pacew/eboard/docs/ESP32-PICO-KIT_V4.1_20180314_EN/04_BOM List/BOM_List.xls

ESP32-PICO-KIT_V4.1 BOM_List(V0.9)
ID | Qty | Ref Des | Value | Package | ICs | Description
1 | 1 | ANT1 | Proant440 | PROANTONBOARD440 | Antenna | 3D Antenna
2 | 2 | C2,C4 | 10uF/25V(10%) | 0603C | Capacitance | Ceramic Capacitor
3 | 5 | C6,C7,C12,C16,C19 | 0.1uF/25V(10%) | 0402C | Capacitance | Ceramic Capacitor
4 | 1 | C15 | 10uF/6.3V(10%) | 0402C | Capacitance | Ceramic Capacitor
5 | 1 | C17 | 2.7pF±0.5pF/25V | 0402C | Capacitor | Ceramic Capacitor
6 | 1 | C18 | 1.6nH±0.3nH | 0402C | Inductor | Inductor
7 | 1 | D1 | RED LED | 0603D/A | LED | Red LED
8 | 1 | D2 | BAT760-7 | SOD-323 | Diode | Diode
9 | 3 | D3,D4,D5 | LESD5D5.0CT1G | SOD-523 | ESD | ESD 5V
10 | 1 | J1 | USB_CON8 | USB_5P | Connector | USB Connector
11 | 2 | J2,J3 | 2.54mm single-row pin headers 17P | CON20_2P54 | Connector | Male Header
12 | 1 | L1 | 4.7pF±0.5pF/25V | 0402C | Capacitor | Ceramic Capacitor
13 | 2 | Q1,Q2 | S8050(NPN) | SOT-23-3 | Transistor | Transistor(NPN)
14 | 2 | R1,R27 | 2K(1%) | 0402R | Resistor | Resistor
15 | 5 | R3,R4,R6,R7,R21 | 0R(1%) | 0402R | Resistor | Resistor
16 | 2 | R15,R16 | 1K(1%) | 0402R | Resistor | Resistor
17 | 3 | R19,R20,R22 | 10K(1%) | 0402R | Resistor | Resistor
18 | 1 | R24 | 22.1K(1%) | 0402R | Resistor | Resistor
19 | 1 | R26 | 47.5K(1%) | 0402R | Resistor | Resistor
20 | 2 | SW1,SW2 | SW PUSHBUTTON | SW_3X4X2MM | Push Button | Push Button
21 | 1 | U1 | AMS1117-3.3 | SOT-223 | Power IC | Power IC
22 | 1 | U4 | CP2102N | QFN28-5X5-0P5 | IC Chip | USB2UART Bridge
23 | 1 | U5 | ESP32-PICO-D4 | QFN48_7X7 | IC Chip | ESP32-SIP
