pacew/eboard/docs/old.pdf

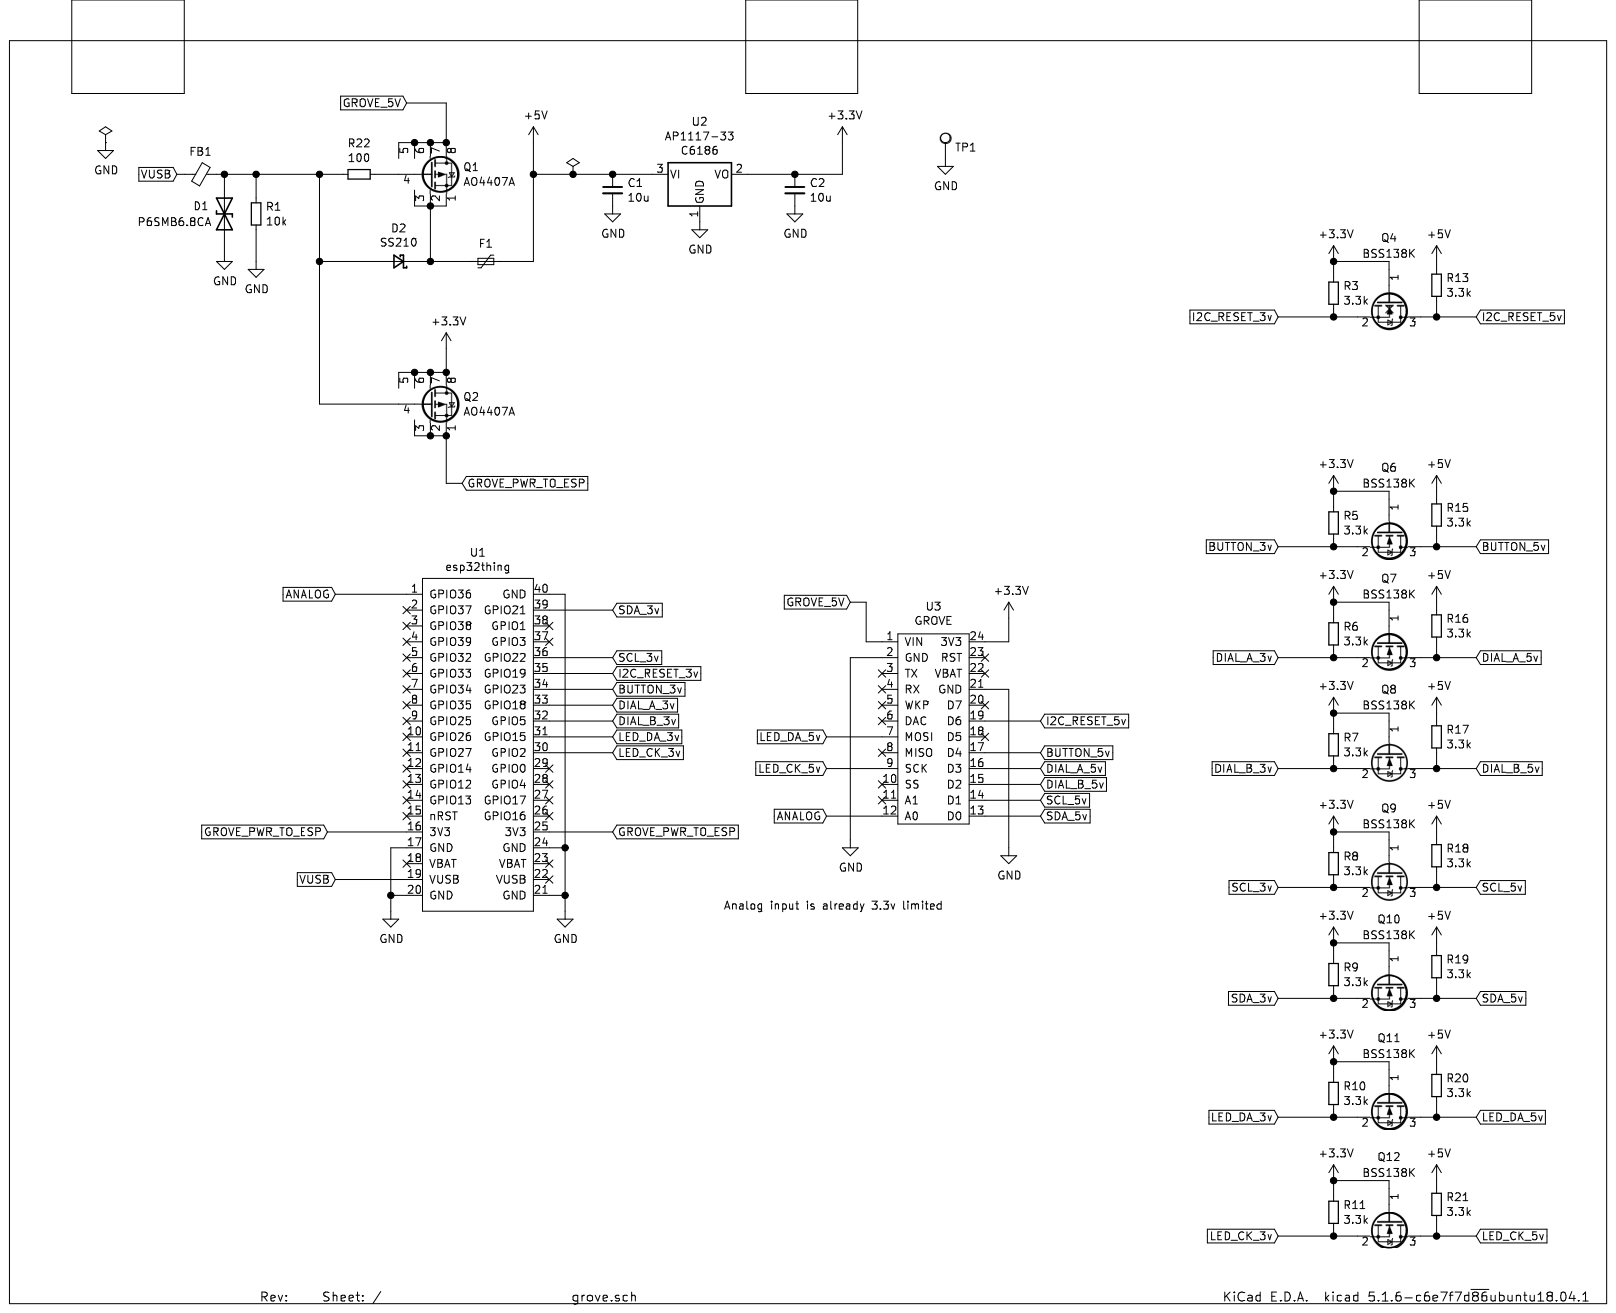
[picture p1: page 1]
