pacew/eboard/(list of files, drawings)

Other design files:
docs/ESP32-PICO-KIT_V4.1_20180314_EN/01_Schematic/ESP32-PICO-KIT-V4.1_0314.DSN
docs/ESP32-PICO-KIT_V4.1_20180314_EN/01_Schematic/esp32-pico-kit-v4.1_0314.opj
docs/ESP32-PICO-KIT_V4.1_20180314_EN/02_PCB Layout/ESP32-PICO-KIT_V4.1_20180314.pcb
