pacew/eboard/eboard/eboard.kicad_pcb

## KiCad design eboard/eboard.kicad_pcb (2021-02-27)

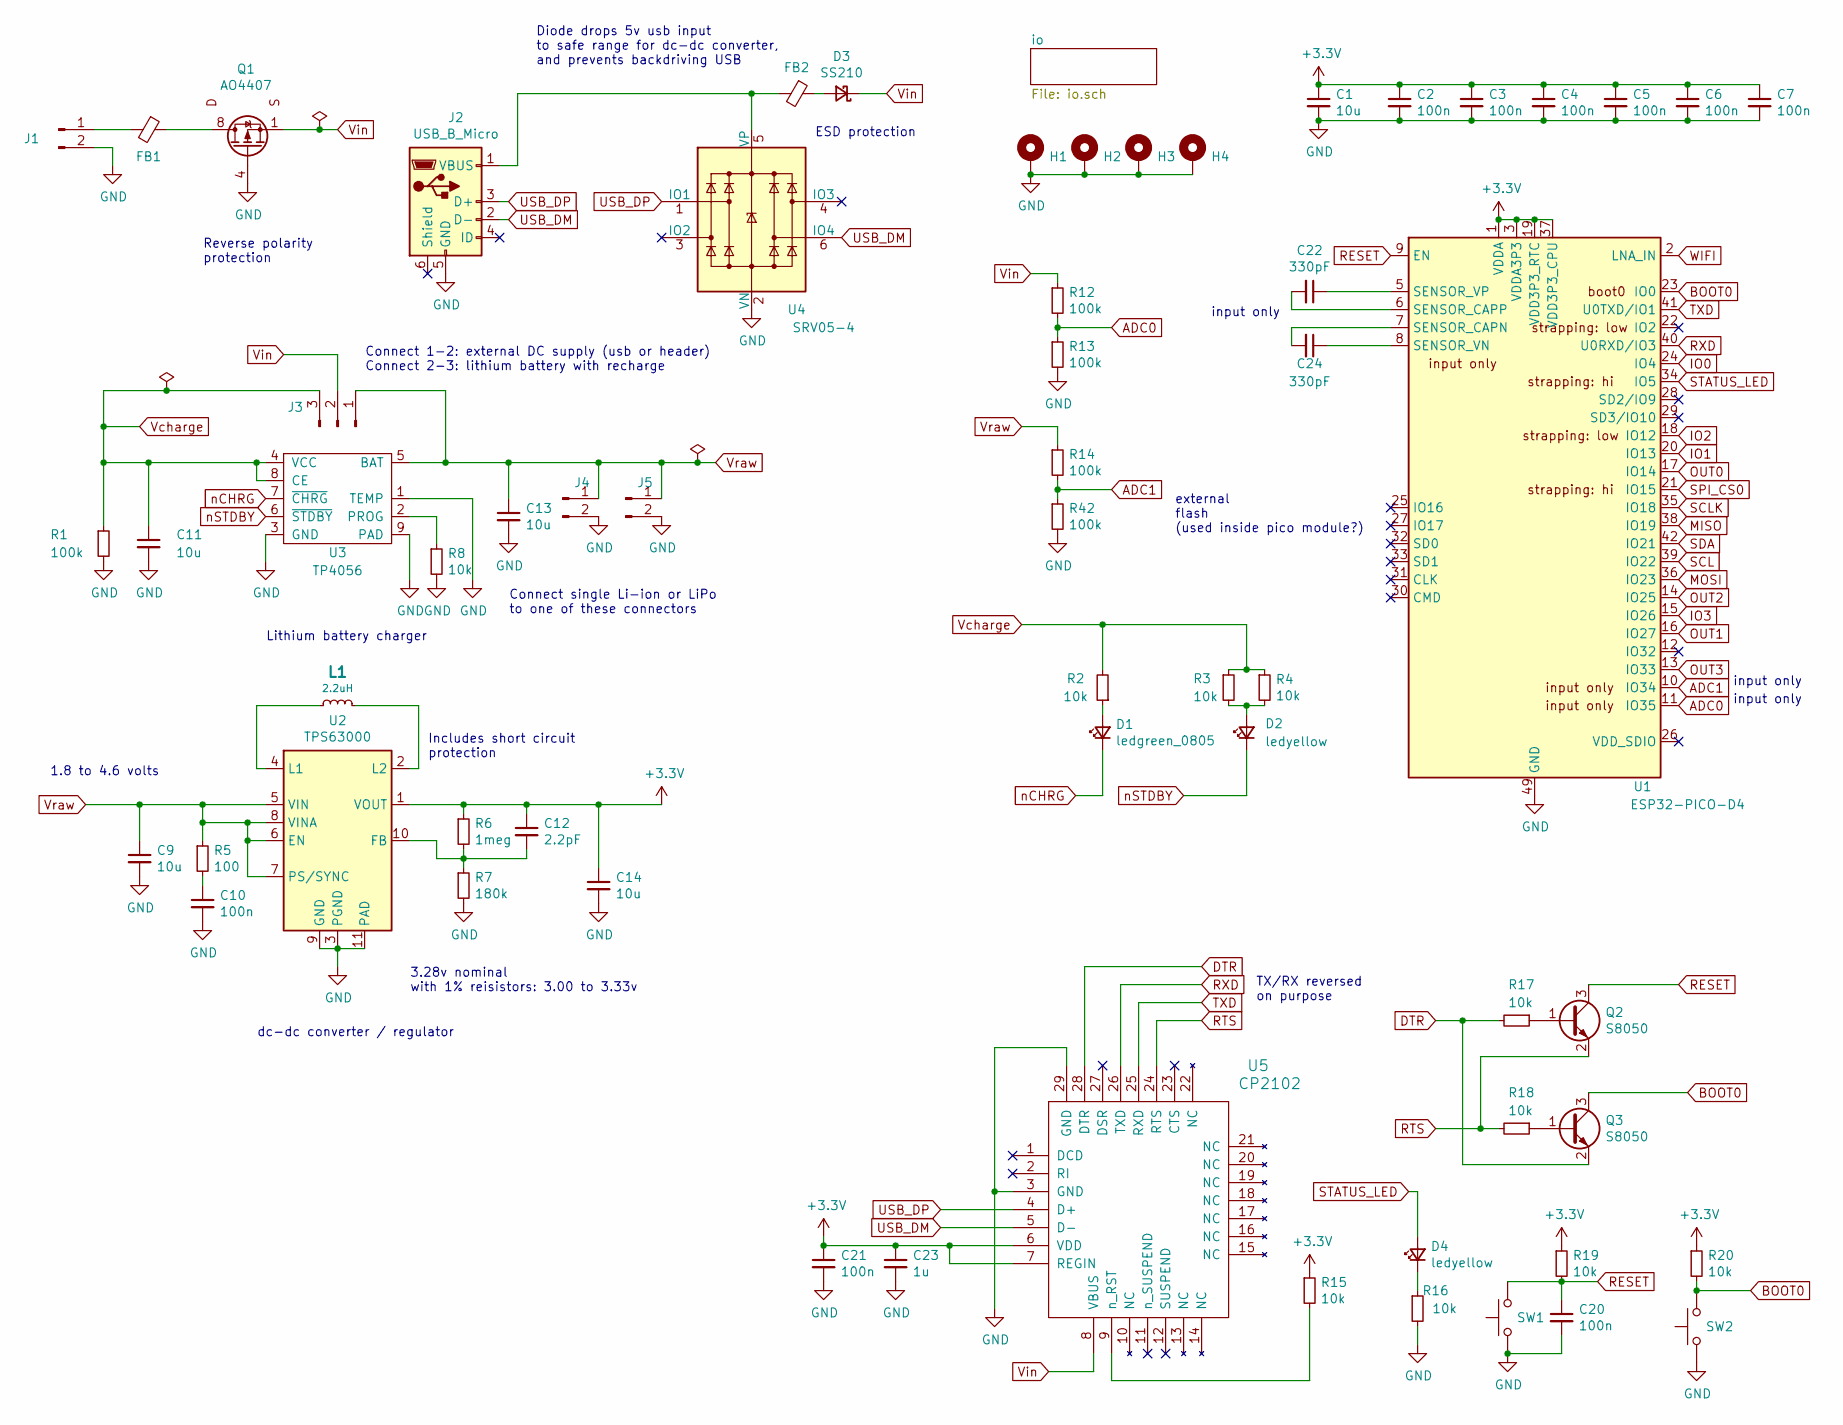
[picture p2: schematic eboard.sch]

Parts:
C1, C9, C11, C13, C14: 10u; C_0402_1005Metric; LCSC C15525
C2, C3, C4, C5, C6, C7, C10, C20, C21: 100n; C_0402_1005Metric; LCSC C1525
C12: 2.2pF; C_0402_1005Metric; LCSC C1559
C22, C24: 330pF; C_0402_1005Metric; LCSC C13533
C23: 1u; C_0402_1005Metric; LCSC C52923
D1: ledgreen_0805; LED_0805_2012Metric; LCSC C2297
D2, D4: ledyellow; LED_0603_1608Metric; LCSC C72038
D3: SS210; D_SMA; LCSC C14996
FB1, FB2: bead; L_0805_2012Metric; LCSC C1015
H1, H2, H3, H4: MountingHole_Pad; MountingHole_3.2mm_M3_Pad
J1, J5: Conn_01x02_Male; PinHeader_1x02_P2.54mm_Vertical
J2: USB_B_Micro; USB_Micro-B_Molex-105017-0001
J3: Conn_01x03_Male; PinHeader_1x03_P2.54mm_Vertical
J4: jst_battery; JST_PH_B2B-PH-K_1x02_P2.00mm_Vertical
L1: 2.2uH; L_Coilcraft_XxL4020; LCSC C167747
Q1: AO4407; SOIC-8_3.9x4.9mm_P1.27mm; LCSC C469397
Q2, Q3: S8050; SOT-23; LCSC C2146
R1, R12, R13, R14, R42: 100k; R_0402_1005Metric; LCSC C25741
R2, R3, R4, R8, R15, R16, R17, R18, R19, R20: 10k; R_0402_1005Metric; LCSC C25744
R5: 100; R_0402_1005Metric; LCSC C25076
R6: 1meg; R_0603_1608Metric; LCSC C22935
R7: 180k; R_0603_1608Metric; LCSC C22827
SW1, SW2: pushbutton_switch; SW_PUSH_6mm
U1: ESP32-PICO-D4; QFN-48-1EP_7x7mm_P0.5mm_EP5.3x5.3mm; LCSC C193707
U2: TPS63000; Texas_DRC0010J_ThermalVias; LCSC C24966
U3: TP4056; SOIC-8-1EP_3.9x4.9mm_P1.27mm_EP2.29x3mm_ThermalVias; LCSC C16581
U4: SRV05-4; SOT-23-6; LCSC C85364
U5: CP2102; QFN-28-1EP_5x5mm_P0.5mm_EP3.35x3.35mm_ThermalVias; LCSC C6568

Connections:
+3V3: C1.1, C2.1, C3.1, C4.1, C5.1, C6.1, C7.1, C12.1, C14.1, C21.1, C23.1, R6.1, R15.1, R19.1, R20.1, U1.1 (VDDA), U1.3 (VDDA3P3), U1.4 (VDDA3P3), U1.19 (VDD3P3_RTC), U1.37 (VDD3P3_CPU), U1.43 (VDDA), U1.46 (VDDA), U2.1 (VOUT), U5.6 (VDD), U5.7 (REGIN); also elsewhere on the board
ADC0: R12.2, R13.1, U1.11 (IO35)
ADC1: R14.2, R42.1, U1.10 (IO34)
BOOT0: Q3.3 (C), R20.2, SW2.2, U1.23 (IO0)
DTR: Q3.2 (E), R17.2, U5.28 (DTR)
GND: C1.2, C2.2, C3.2, C4.2, C5.2, C6.2, C7.2, C9.2, C10.2, C11.2, C13.2, C14.2, C20.2, C21.2, C23.2, H1.1, H2.1, H3.1, H4.1, J1.2, J2.5 (GND), J4.2, J5.2, Q1.4 (G), R1.2, R7.2, R8.2, R13.2, R16.2, R42.2, SW1.1, SW2.1, U1.49 (GND), U2.3 (PGND), U2.9 (GND), U2.11 (PAD), U3.1 (TEMP), U3.3 (GND), U3.9 (PAD), U4.2 (VN), U5.3 (GND), U5.29 (GND); also elsewhere on the board
IO0: U1.24 (IO4); also elsewhere on the board
IO1: U1.20 (IO13); also elsewhere on the board
IO2: U1.18 (IO12); also elsewhere on the board
IO3: U1.15 (IO26); also elsewhere on the board
MISO: U1.38 (IO19); also elsewhere on the board
MOSI: U1.36 (IO23); also elsewhere on the board
unnamed: C10.1, R5.2
unnamed: C12.2, R6.2, R7.1, U2.10 (FB)
unnamed: C22.1, U1.5 (SENSOR_VP)
unnamed: C22.2, U1.6 (SENSOR_CAPP)
unnamed: C24.1, U1.8 (SENSOR_VN)
unnamed: C24.2, U1.7 (SENSOR_CAPN)
unnamed: D1.2 (A), R2.1
unnamed: D2.2 (A), R3.2, R4.2
unnamed: D3.2 (A), FB2.1
unnamed: D4.1 (K), R16.1
unnamed: FB1.1, Q1.5 (Dd), Q1.6 (Dc), Q1.7 (Db), Q1.8 (D)
unnamed: FB1.2, J1.1
unnamed: FB2.2, J2.1 (VBUS), U4.5 (VP)
unnamed: L1.1, U2.4 (L1)
unnamed: L1.2, U2.2 (L2)
unnamed: Q2.1 (B), R17.1
unnamed: Q3.1 (B), R18.1
unnamed: R8.1, U3.2 (PROG)
unnamed: R15.2, U5.9 (n_RST)
OUT0: U1.17 (IO14); also elsewhere on the board
OUT1: U1.16 (IO27); also elsewhere on the board
OUT2: U1.14 (IO25); also elsewhere on the board
OUT3: U1.13 (IO33); also elsewhere on the board
RESET: C20.1, Q2.3 (C), R19.2, SW1.2, U1.9 (EN)
RTS: Q2.2 (E), R18.2, U5.24 (RTS)
RXD: U1.40 (U0RXD/IO3), U5.26 (TXD)
SCL: U1.39 (IO22); also elsewhere on the board
SCLK: U1.35 (IO18); also elsewhere on the board
SDA: U1.42 (IO21); also elsewhere on the board
SPI_CS0: U1.21 (IO15); also elsewhere on the board
STATUS_LED: D4.2 (A), U1.34 (IO5)
TXD: U1.41 (U0TXD/IO1), U5.25 (RXD)
USB_DM: J2.2 (D-), U4.6 (IO4), U5.5 (D-)
USB_DP: J2.3 (D+), U4.1 (IO1), U5.4 (D+)
Vcharge: C11.1, J3.3, R1.1, R2.2, R3.1, R4.1, U3.4 (VCC), U3.8 (CE)
Vin: D3.1 (K), J3.2, Q1.1 (S), Q1.2 (Sb), Q1.3 (Sc), R12.1, U5.8 (VBUS)
Vraw: C9.1, C13.1, J3.1, J4.1, J5.1, R5.1, R14.1, U2.5 (VIN), U2.6 (EN), U2.7 (PS/SYNC), U2.8 (VINA), U3.5 (BAT)
WIFI: U1.2 (LNA_IN); also elsewhere on the board
nCHRG: D1.1 (K), U3.7 (~CHRG)
nSTDBY: D2.1 (K), U3.6 (~STDBY)

Notes on the sheet:
3.28v nominal with 1% reisistors: 3.00 to 3.33v
Includes short circuit protection
1.8 to 4.6 volts
Reverse polarity protection
ESD protection
Lithium battery charger
dc-dc converter / regulator
Connect 1-2: external DC supply (usb or header) Connect 2-3: lithium battery with recharge
Connect single Li-ion or LiPo to one of these connectors
external flash (used inside pico module?)
input only
Diode drops 5v usb input to safe range for dc-dc converter, and prevents backdriving USB
TX/RX reversed on purpose

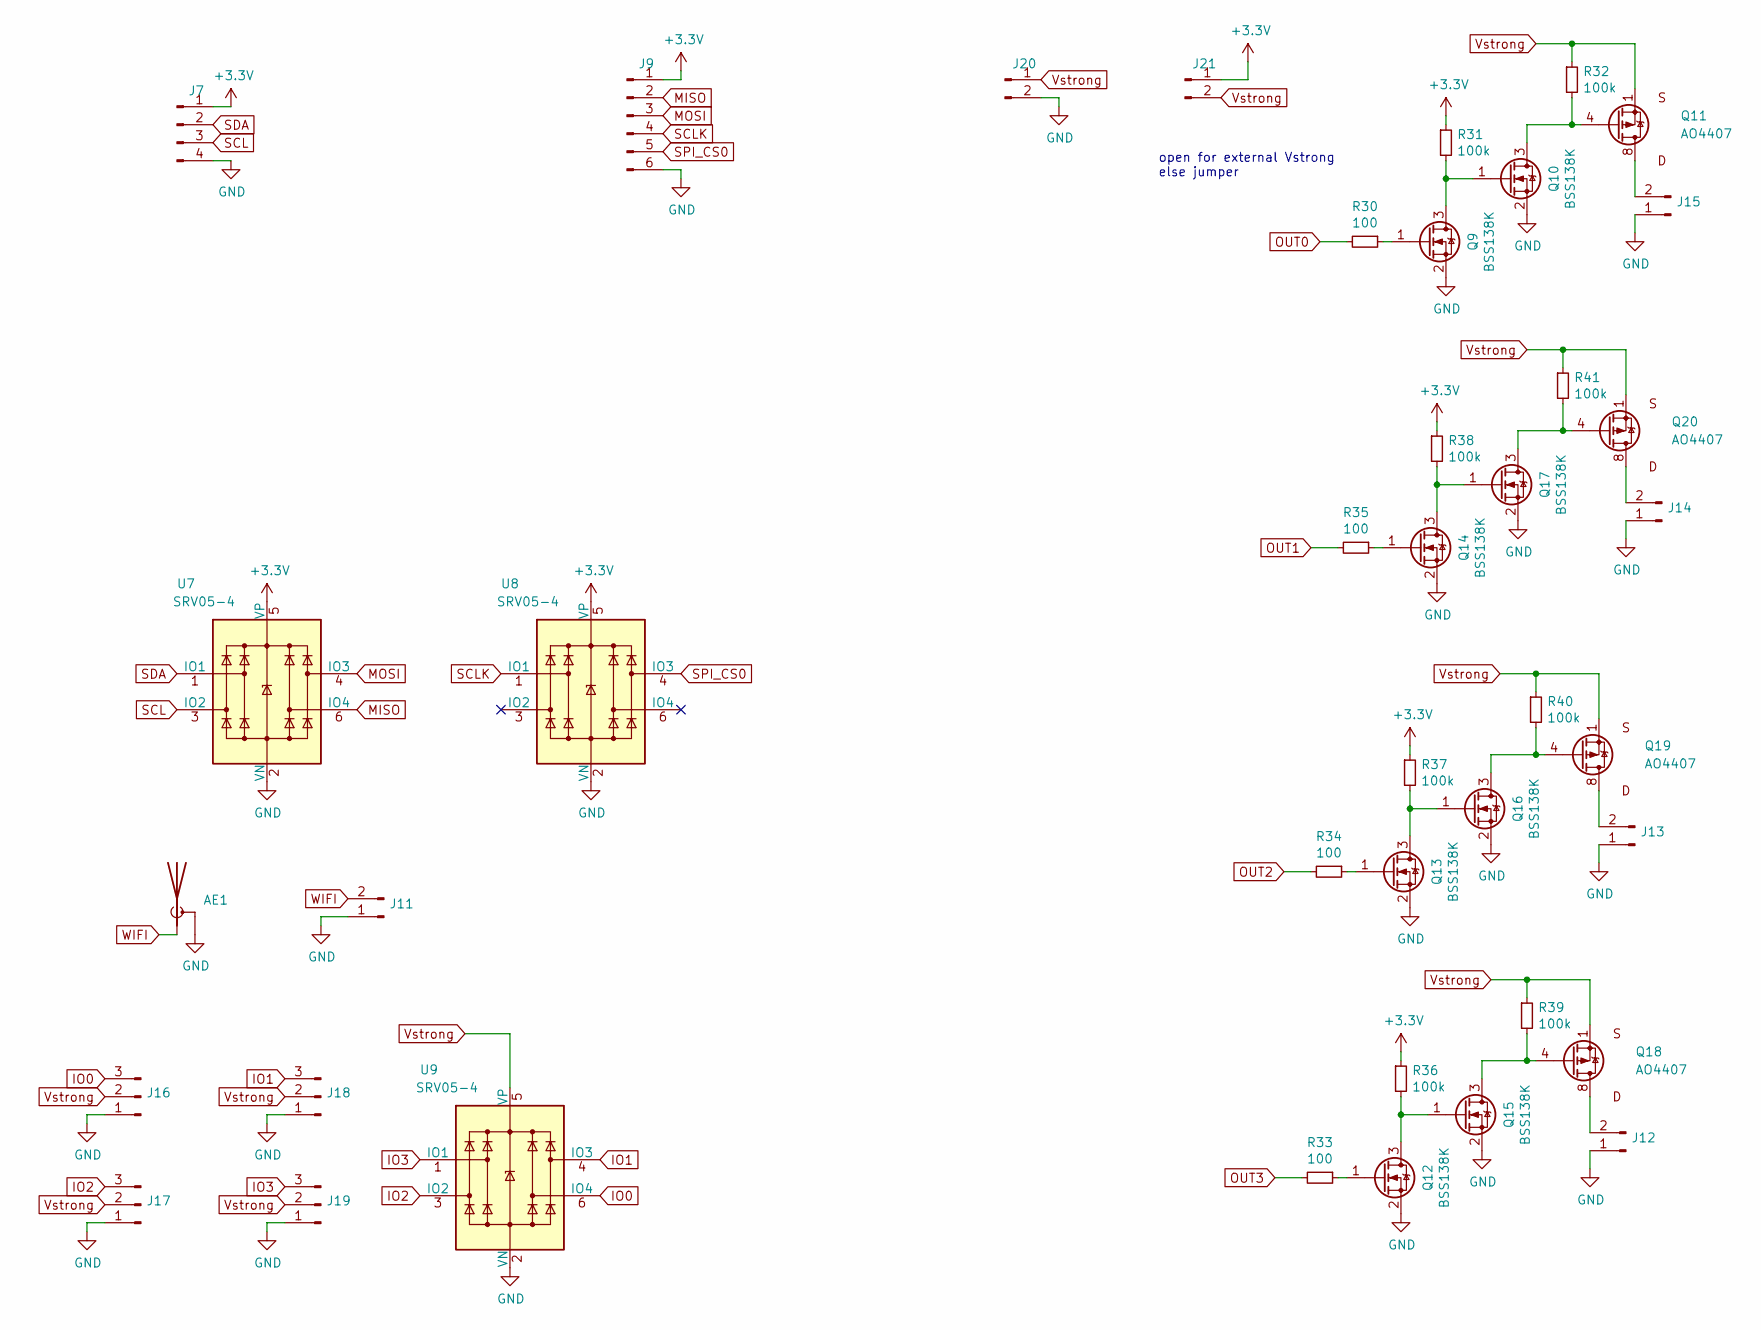
[picture p3: schematic io.sch]

Parts:
AE1: Antenna_Shield; SMA_Samtec_SMA-J-P-X-ST-EM1_EdgeMount
J7: Conn_01x04_Male; PinHeader_1x04_P2.54mm_Vertical
J9: Conn_01x06_Male; PinHeader_1x06_P2.54mm_Vertical
J11, J12, J13, J14, J15, J20, J21: Conn_01x02_Male; PinHeader_1x02_P2.54mm_Vertical
J16, J17, J18, J19: Conn_01x03_Male; PinHeader_1x03_P2.54mm_Vertical
Q9, Q10, Q12, Q13, Q14, Q15, Q16, Q17: BSS138K; SOT-23; LCSC C255592
Q11, Q18, Q19, Q20: AO4407; SOIC-8_3.9x4.9mm_P1.27mm; LCSC C469397
R30, R33, R34, R35: 100; R_0402_1005Metric; LCSC C25076
R31, R32, R36, R37, R38, R39, R40, R41: 100k; R_0402_1005Metric; LCSC C25741
U7, U8, U9: SRV05-4; SOT-23-6; LCSC C85364

Connections:
+3V3: J7.1, J9.1, J21.1, R31.1, R36.1, R37.1, R38.1, U7.5 (VP), U8.5 (VP); also elsewhere on the board
GND: AE1.2 (Shield), J7.4, J9.6, J11.1, J12.1, J13.1, J14.1, J15.1, J16.1, J17.1, J18.1, J19.1, J20.2, Q9.2 (S), Q10.2 (S), Q12.2 (S), Q13.2 (S), Q14.2 (S), Q15.2 (S), Q16.2 (S), Q17.2 (S), U7.2 (VN), U8.2 (VN), U9.2 (VN); also elsewhere on the board
IO0: J16.3, U9.6 (IO4); also elsewhere on the board
IO1: J18.3, U9.4 (IO3); also elsewhere on the board
IO2: J17.3, U9.3 (IO2); also elsewhere on the board
IO3: J19.3, U9.1 (IO1); also elsewhere on the board
MISO: J9.2, U7.6 (IO4); also elsewhere on the board
MOSI: J9.3, U7.4 (IO3); also elsewhere on the board
unnamed: J12.2, Q18.5 (Dd), Q18.6 (Dc), Q18.7 (Db), Q18.8 (D)
unnamed: J13.2, Q19.5 (Dd), Q19.6 (Dc), Q19.7 (Db), Q19.8 (D)
unnamed: J14.2, Q20.5 (Dd), Q20.6 (Dc), Q20.7 (Db), Q20.8 (D)
unnamed: J15.2, Q11.5 (Dd), Q11.6 (Dc), Q11.7 (Db), Q11.8 (D)
unnamed: Q9.1 (G), R30.1
unnamed: Q9.3 (D), Q10.1 (G), R31.2
unnamed: Q10.3 (D), Q11.4 (G), R32.2
unnamed: Q12.1 (G), R33.1
unnamed: Q12.3 (D), Q15.1 (G), R36.2
unnamed: Q13.1 (G), R34.1
unnamed: Q13.3 (D), Q16.1 (G), R37.2
unnamed: Q14.1 (G), R35.1
unnamed: Q14.3 (D), Q17.1 (G), R38.2
unnamed: Q15.3 (D), Q18.4 (G), R39.2
unnamed: Q16.3 (D), Q19.4 (G), R40.2
unnamed: Q17.3 (D), Q20.4 (G), R41.2
OUT0: R30.2; also elsewhere on the board
OUT1: R35.2; also elsewhere on the board
OUT2: R34.2; also elsewhere on the board
OUT3: R33.2; also elsewhere on the board
SCL: J7.3, U7.3 (IO2); also elsewhere on the board
SCLK: J9.4, U8.1 (IO1); also elsewhere on the board
SDA: J7.2, U7.1 (IO1); also elsewhere on the board
SPI_CS0: J9.5, U8.4 (IO3); also elsewhere on the board
Vstrong: J16.2, J17.2, J18.2, J19.2, J20.1, J21.2, Q11.1 (S), Q11.2 (Sb), Q11.3 (Sc), Q18.1 (S), Q18.2 (Sb), Q18.3 (Sc), Q19.1 (S), Q19.2 (Sb), Q19.3 (Sc), Q20.1 (S), Q20.2 (Sb), Q20.3 (Sc), R32.1, R39.1, R40.1, R41.1, U9.5 (VP)
WIFI: AE1.1 (A), J11.2; also elsewhere on the board

Notes on the sheet:
open for external Vstrong else jumper

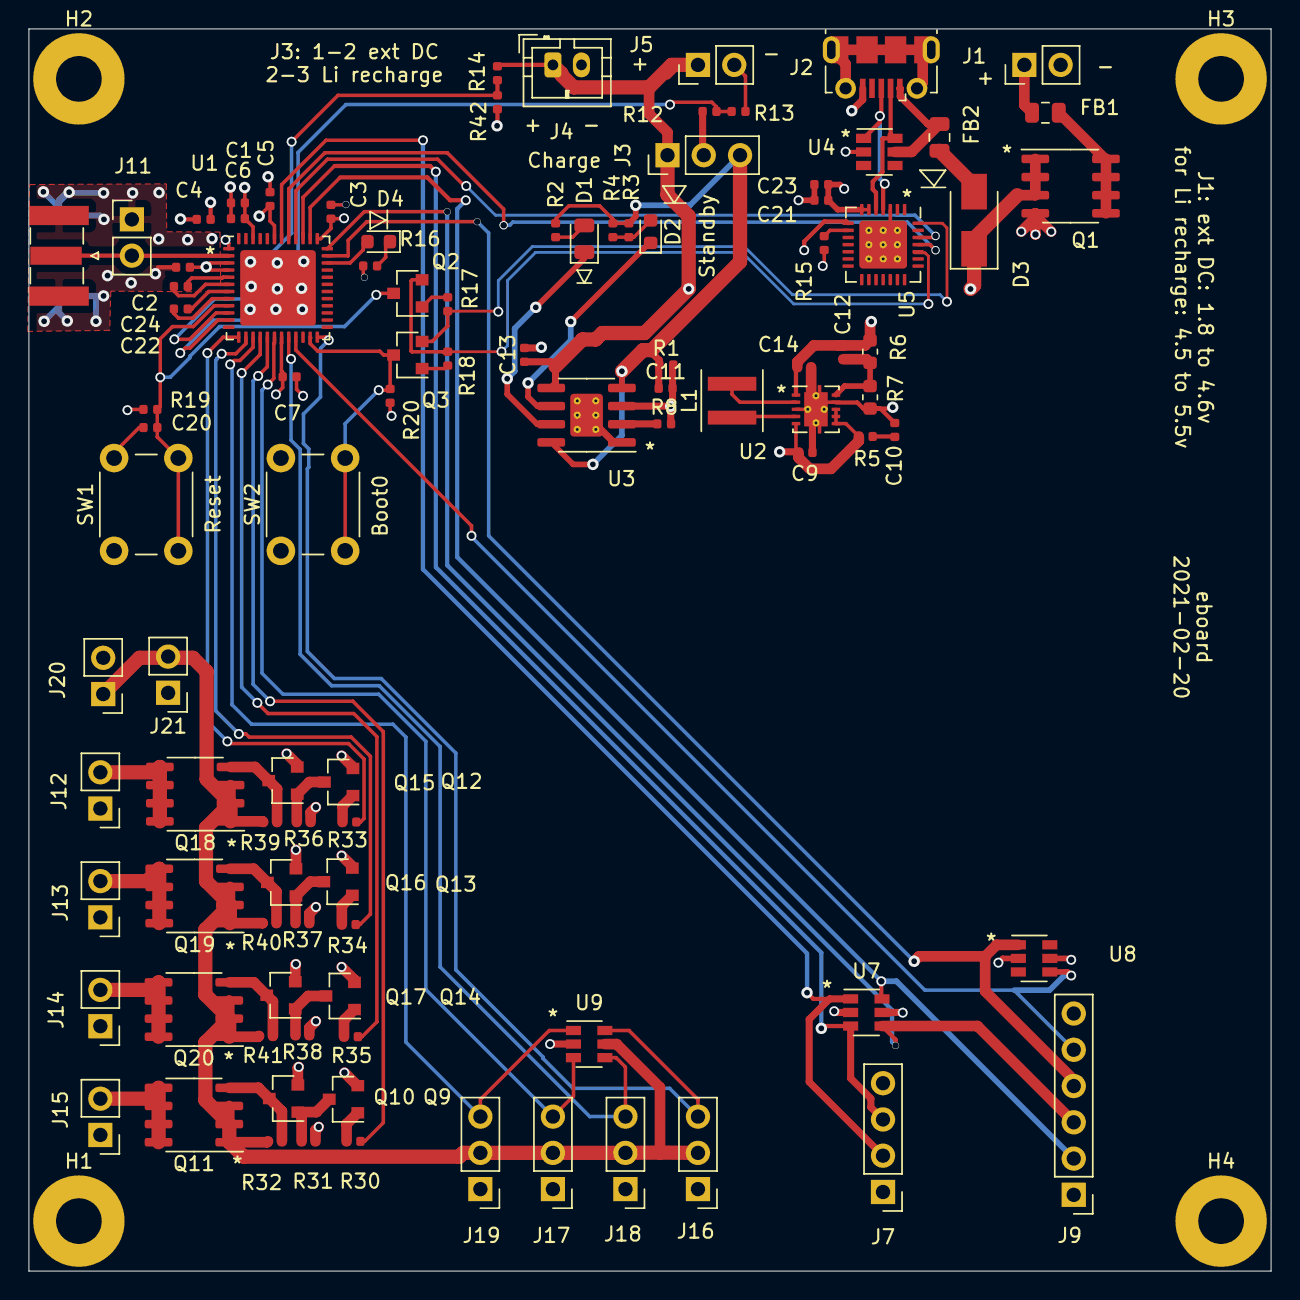
[picture p4: board eboard.kicad_pcb from above]

Board: 4 copper layers, 87.0 x 87.0 mm, 103 parts (0 on the bottom side), 69 nets.
