pacew/eboard/(commit log)

2020-12-28 ecos from v1
    [eboard.kicad_pcb, eboard.sch]
2020-12-28 remove 5v
    [eboard.kicad_pcb, eboard.sch, io.sch]
